AMasetti/NexusFirmware/docs/logs/DEV_LOG_2026-04-16.md

# Optimus Biped — Dev Log 2026-04-16

## Goal
Get the CPG walking algorithm running on real hardware: ESP32-C3 Super Mini → PCA9685 → 8× MG995 servos, wired to match the legacy biped robot channel layout.

---

## Bug 1 — FQBN: `USBMode` option does not exist

**Symptom:** `arduino-cli compile` failed immediately:
```
Error: Invalid FQBN: invalid option 'USBMode'
```
**Root cause:** The `sketch.yaml` was copied from another project targeting a different ESP32 variant. The installed `esp32:esp32` core version (3.3.8) does not expose a `USBMode` option for the C3 — `CDCOnBoot=cdc` alone is sufficient.

**Fix:** Removed `USBMode=hwcdc` from both `Makefile` and `sketch.yaml`:
```
# Before
esp32:esp32:esp32c3:USBMode=hwcdc,CDCOnBoot=cdc,PartitionScheme=huge_app
# After
esp32:esp32:esp32c3:CDCOnBoot=cdc,PartitionScheme=huge_app
```

---

## Bug 2 — Compile error: `volatile` struct assignment

**Symptom:**
```
error: passing 'volatile IMUEstimate' as 'this' argument discards qualifiers
error: passing 'volatile LegAngles' as 'this' argument discards qualifiers
```
**Root cause:** Shared globals `g_imu_estimate` and `g_leg_angles` were declared `volatile`. The compiler-generated `operator=` is not `volatile`-qualified so the assignment is rejected.

**Fix:** Replaced both struct assignments with `memcpy` through a void pointer:
```cpp
memcpy((void*)&g_imu_estimate, &est,    sizeof(IMUEstimate));
memcpy((void*)&g_leg_angles,   &angles, sizeof(LegAngles));
```

---

## Bug 3 — Runtime crash: `xTaskCreatePinnedToCore` assert

**Symptom:** Board booted, reached task creation, then panicked:
```
assert failed: xTaskCreatePinnedToCore ... (xCoreID < 1)
```
**Root cause:** All three FreeRTOS tasks were pinned to core `1`. The ESP32-C3 is **single-core** — only core `0` exists.

**Fix:** Changed all `xTaskCreatePinnedToCore` calls to core `0`:
```cpp
xTaskCreatePinnedToCore(task_cpg, "cpg", ..., nullptr, 0);
```

---

## Bug 4 — WebSockets library missing

**Symptom:**
```
fatal error: WebSocketsServer.h: No such file or directory
```
**Root cause:** The `arduinoWebSockets` library (Links2004) was not installed.

**Fix:** Added `make install-libs` target to `Makefile` and ran it:
```makefile
LIBS := "WebSockets"
install-libs:
    $(ARDUINO_CLI) core install esp32:esp32
    $(ARDUINO_CLI) lib install $(LIBS)
```

---

## Bug 5 — GPIO 22 does not exist on ESP32-C3

**Symptom:** I2C scan found no devices. `PCA9685 OK` printed anyway (separate bug, see #6).

**Root cause:** `config.h` had `I2C_SCL_PIN = 22`. The ESP32-C3 Super Mini only exposes GPIOs 0–10, 20, 21. GPIO 22 does not exist — the SCL line was floating.

**Fix:**
```c
#define I2C_SDA_PIN  8
#define I2C_SCL_PIN  9
```

---

## Bug 6 — PCA9685 falsely reports "OK" when not present

**Symptom:** Even with GPIO 22 (invalid), serial printed `[SERVO] PCA9685 OK`. The presence check was:
```cpp
uint8_t mode1 = read_reg(PCA9685Reg::MODE1);
if (mode1 == 0xFF) return false;
```
**Root cause:** When no device is on the bus, `Wire.requestFrom()` returns 0 bytes and `read_reg` returns `0`. Since `0 ≠ 0xFF`, the check passed.

**Fix:** Replaced with an explicit ACK check:
```cpp
Wire.beginTransmission(addr_);
if (Wire.endTransmission() != 0) return false;
```

---

## Bug 7 — PCA9685 register writes silently failing (all readbacks = 0)

**Symptom:** Added register readback to `set_angle()`. Every write showed `MISMATCH!`:
```
[PCA9685] ch0  20.0° → 1661us tick=340  readback=0 MISMATCH!
```
Servos were connected, powered, and PCA9685 was ACKing on I2C — but physically not moving.

**Root cause:** The **Auto-Increment (AI) bit** (MODE1 bit 5) was never set. Without it, a multi-byte I2C burst write (used by `set_pwm` to write 4 bytes: ON_L, ON_H, OFF_L, OFF_H) does not advance the internal register pointer — all 4 bytes land on the same register. The OFF register stays at 0, producing no pulse width.

**Fix:** Rewrote the `begin()` init sequence to explicitly set AI=1:
```cpp
write_reg(PCA9685Reg::MODE1, 0x10);  // SLEEP=1 (required before prescaler write)
delay(5);
write_reg(PCA9685Reg::PRESCALE, prescale);
write_reg(PCA9685Reg::MODE1, 0x20);  // AI=1, SLEEP=0
delay(5);
write_reg(PCA9685Reg::MODE1, 0xA0);  // RESTART=1, AI=1
delay(5);
```
After this fix readbacks matched and servos moved immediately.

---

## Bug 8 — Wrong pulse range → halt positions off

**Symptom:** Servos moved but resting positions were visibly wrong compared to the robot's known good halt pose.

**Root cause:** Firmware used MG995 datasheet range (500–2400 µs). The old robot (`servos_lib.py`) used 600–2650 µs. Center (0°) maps to different pulse widths:
- 500–2400 µs → center = 1450 µs
- 600–2650 µs → center = 1625 µs

The 175 µs difference shifted every servo's halt position.

**Fix:** Matched firmware to old robot:
```c
#define SERVO_PWM_MIN  600   // µs
#define SERVO_PWM_MAX  2650  // µs
```
The per-servo `SERVO_OFFSET_DEG_*` values (derived as `halt_deg − 90`) are now correct.

---

## Bug 9 — Feet sliding, no lift, walking sideways

**Symptom:** Robot moved but feet dragged along the floor. No lift. Body rotated CCW viewed from top.

**Root cause (phase):** `CPG_PHASE_KNEE_OFFSET = -π/4` caused the knee to start bending *after* the foot had already planted — producing drag not lift. Also `CPG_HIP_PITCH_BASE_PHASE = π` was added to fix backward direction but not propagated to the knee formula, putting knee π out of phase with hip.

**Root cause (direction):** `SERVO_DIR_R_KNEE` was incorrectly changed to `-1`. With anti-phase CPG, the right knee CPG signal is already negated relative to the left. Applying dir=-1 on top negated it again → both knees bent simultaneously → no alternating lift → CCW body rotation.

**Fix:**
- `SERVO_DIR_R_KNEE = +1` (restore original — anti-phase is handled by the CPG, not the direction table)
- `CPG_PHASE_KNEE_OFFSET = 0` (knee in-phase with hip pitch: foot is up during forward swing)
- `CPG_HIP_PITCH_BASE_PHASE = 0` (forward direction confirmed with correct knee phase)
- Apply `CPG_HIP_PITCH_BASE_PHASE` to knee formula in `cpg.cpp` so all joints stay consistent

---

## Bug 10 — Walking backward

**Symptom:** After phase fixes, robot walked but in reverse.

**Root cause:** Multiple sign flips during debugging left the net hip pitch direction inverted. The hip pitch CPG value was positive-forward in the math but negative-forward physically.

**Fix:** Traced the full physical chain:
- `SERVO_DIR_L_HIP_PITCH = +1` (set_inverse=False, ch13) — positive CPG = servo increases = forward swing ✓
- `SERVO_DIR_R_HIP_PITCH = -1` (set_inverse=True, ch2) — positive CPG × (−1) = servo decreases = forward swing ✓ (right side is mechanically mirrored)
- `CPG_HIP_PITCH_BASE_PHASE = 0` confirmed correct with these directions

---

## Final working configuration (end of day)

### CPG parameters
```c
#define CPG_PERIOD_S              1.2f     // slower = more stable
#define CPG_HIP_PITCH_AMP         0.40f    // ~23° stride
#define CPG_KNEE_AMP              0.50f    // ~29° lift
#define CPG_HIP_ROLL_AMP          0.18f    // ~10° lateral CoM shift
#define CPG_ANKLE_ROLL_AMP        0.10f    // ~6°
#define CPG_HIP_PITCH_BASE_PHASE  0.0f     // forward
#define CPG_PHASE_HIP_PITCH_R     3.14159f // anti-phase L vs R
#define CPG_PHASE_KNEE_OFFSET     0.0f     // in-phase with hip — lifts during swing
#define CPG_PHASE_HIP_ROLL        1.5708f  // π/2 — shifts weight to stance leg
#define CPG_KNEE_STANDING_OFFSET_RAD  0.40f
```

### Servo directions (verified physically)
| ch | Joint | dir | Reasoning |
|----|---|-----|---|
| 0 | R ankle_roll | +1 | set_inverse=False |
| 1 | R knee | +1 | set_inverse=False; anti-phase CPG handles alternation |
| 2 | R hip_pitch | −1 | set_inverse=True; mirrored mounting |
| 3 | R hip_roll | −1 | set_inverse=True; mirrored mounting |
| 12 | L hip_roll | +1 | set_inverse=False |
| 13 | L hip_pitch | +1 | set_inverse=False |
| 14 | L knee | −1 | set_inverse=True |
| 15 | L ankle_roll | −1 | set_inverse=True |

### Halt offsets (derived from robot_config.py: offset = halt_deg − 90)
| ch | halt° | offset |
|----|---|---|
| 0 | 90 | 0 |
| 1 | 80 | −10 |
| 2 | 100 | +10 |
| 3 | 100 | +10 |
| 12 | 80 | −10 |
| 13 | 90 | 0 |
| 14 | 90 | 0 |
| 15 | 70 | −20 |

### Key firmware fixes
- PCA9685 init: set `MODE1 = 0x20` (AI=1) before RESTART — without this all multi-byte writes fail silently
- I2C SCL: GPIO 9 (GPIO 22 does not exist on ESP32-C3)
- Pulse range: 600–2650 µs (not 500–2400)
- FreeRTOS: all tasks on core 0 (C3 is single-core)

---

## Remaining issues (open at end of day)
- Left leg still moves more than right leg — likely a remaining direction or offset asymmetry to tune
- Right knee bottom bending inward at halt — offset for ch1 may need further calibration
- IMU (MPU6050) not yet connected — stabilizer and safety cutoff inactive (`USE_IMU 0`)
- Walking still not clean forward motion — CPG phase tuning ongoing

---

## Files changed today
- `optimus/firmware/include/config.h` — pins, pulse range, channel map, CPG params, calibration table
- `optimus/firmware/src/main.cpp` — core 0, volatile memcpy, diagnostic I2C scan, servo sweep, CPG logging
- `optimus/firmware/src/servo/pca9685.cpp` — ACK presence check, AI bit init, diagnostic readback
- `optimus/firmware/src/gait/cpg.cpp` — base phase applied consistently to hip and knee
- `optimus/firmware/Makefile` — FQBN fix, install-libs target, monitor target
- `optimus/firmware/sketch.yaml` — FQBN fix
- `optimus/JOINTS.md` — full joint and firmware reference documentation created
