AMasetti/NexusFirmware/firmware/firmware.ino

// Optimus Biped — Arduino CLI sketch entry point
//
// setup() and loop() are defined in src/main.cpp.
// This file exists so arduino-cli recognises the folder as a sketch.
// All source files under src/ are compiled automatically.
