AMasetti/NexusFirmware/(commit log)

2026-06-20 feat: enforce per-joint limits on all set_joint commands (legs + arms)
    Adds per-joint soft limits to config.h for all 15 DOF.
    Legs: hip ±45°, knee ±70°, ankle ±90°.
    Arms: shoulder ±120°, forearm ±90°, hip_yaw ±45°.
    Extends resolve_arm_joint() to map arm joint names to PCA9685 channels.
    All set_joint commands now clamp before writing to the servo.
    [config.h, main.cpp]
2026-06-20 broadcast arm joint positions in telemetry (NEX-5)
    Add g_arm_angles[7] global — updated under state_mutex whenever a set_joint
    arm command is received. Initialize to 0 (halt pose on boot).
    Extend RobotState with arms[7] and build_json to emit all 7 arm joints
    (r_shoulder_fb/lat, r_forearm_lat, l_shoulder_fb/lat, l_forearm_lat, hip_yaw)
    alongside the existing 8 leg joints. Bump tx_buf_ from 640 to 800 bytes.
    task_telemetry copies g_arm_angles into state.arms under the same mutex
    window as leg angles, ensuring a consistent snapshot per broadcast.
2026-06-20 ci: fix arduino-cli PATH by using setup-arduino-cli action
2026-08-11 feat: firmware-rl + rl_runner.py — WiFi inference (Option A)
    firmware-rl/: ESP32 firmware stripped to hardware bridge only.
    - Reads IMU at 100 Hz via complementary filter
    - Receives absolute joint angles from PC via WebSocket (set_joints cmd)
    - Writes 15 DOF to PCA9685 at 50 Hz with soft limits
    - Safety cutoff: freezes servos if tilt > 50° or PC goes silent > 200ms
    - Shares imu/ and servo/ drivers with firmware/ via symlinks
    - Reachable as optimus-rl.local
    tools/rl_runner.py: PC-side inference loop at 50 Hz.
    - Loads Run 27 best_model.zip + vecnorm.pkl
    - Runs CPG oscillator (mirrors mujuco/optimus/rl/cpg.py)
    - Receives IMU + joints from ESP32, builds obs vector matching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
    [config.h, firmware-rl.ino, main.cpp, rl_runner.py]
2026-08-11 fix: rl_runner vecnorm loading and model path handling
    - abs path resolves correctly regardless of cwd
    - strip .zip before passing to SB3 (avoids .zip.zip)
    - load obs_rms directly from pickle instead of VecNormalize dummy env
    (avoids shape mismatch assertion on obs_space 51 != 3)
    [rl_runner.py]
2026-10-02 chore: drop deprecated JoyCon tool, move kinematics plot into tools/
2026-10-02 refactor(imu): move IMUEstimate into imu/imu_estimate.h
2026-10-02 fix(firmware-rl): build against shared drivers, apply arm servo dir/offset
    [config.h, firmware-rl.ino]
2026-10-02 tune(firmware): arm lateral offsets so 0 rad hangs arms at the sides
2026-10-02 fix(rl_runner): build observations over all 23 sim joints, incl. passive linkage
    [rl_runner.py]
